guimeira/fpg8/docs/presentation.pdf

Worcester Polytechnic Institute

Department of Electrical and Computer Engineering

# FPG-8: A Chip-8/S-Chip implementation in Verilog

Guilherme Tebaldi Meira

### Chip-8

- Simple interpreted language
- Created in the mid-1970’s for the COSMAC VIP and Telmac 1800
- Focused on the creation of simple games
- “Hello world” of emulators

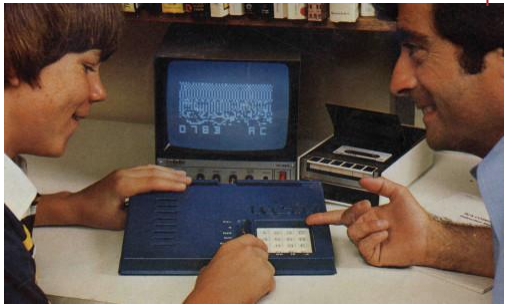
[picture p1: figure]

### Chip-8 Specifications

- 4kB of RAM
- 16 general purpose registers (V0-VF)
- Stack for function calls
- 60Hz Timers
- Delay timer
- Sound timer
- Hexadecimal keyboard
- 64x32 monochromatic display
- Sprites
- 8 pixels wide
- 1 to 10 pixels tall
- 35 opcodes

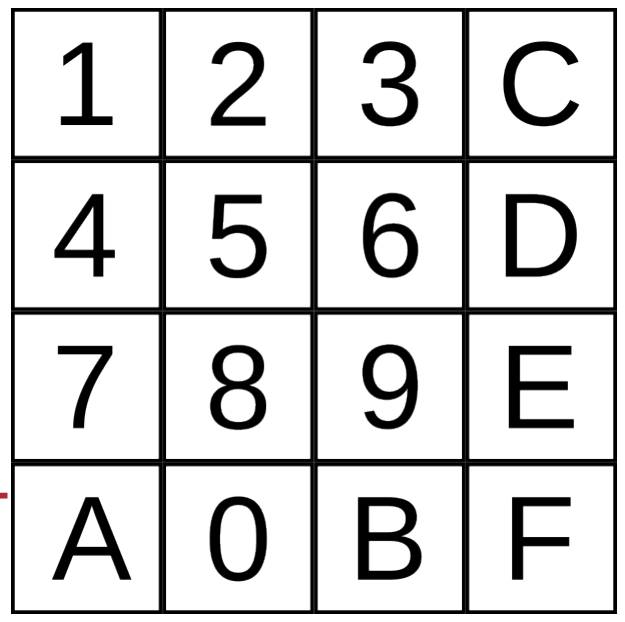
[picture p2: figure]

### S-Chip Extension

- 128x64 video mode
- 16x16 sprites
- 10 new opcodes
- Screen manipulation (scroll up, left and right)
- Switch between video modes
- Interaction with HP-48 (not implemented)
- Exit

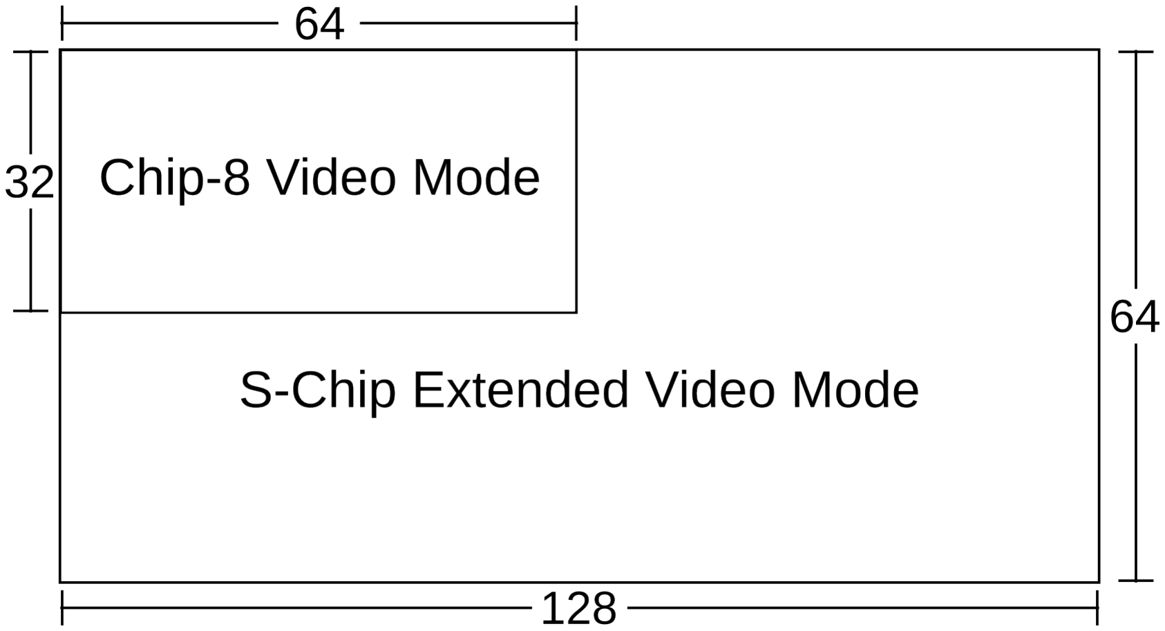
[picture p3: figure]
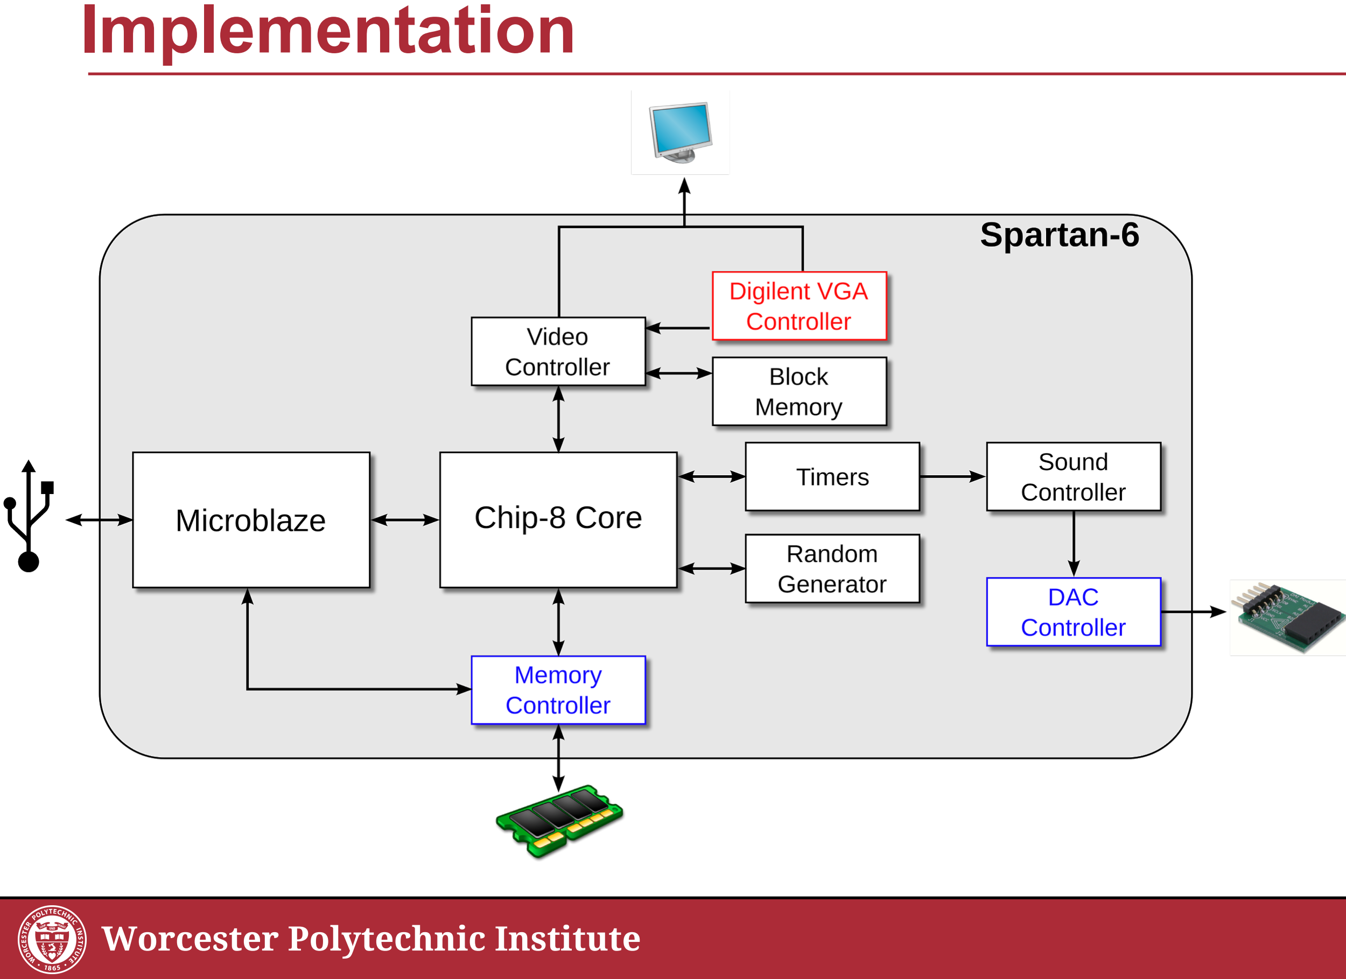
[picture p4: page 5]

### Implementation

### Serial Interface Protocol

- Load a game into the SRAM
- Start/stop the processor
- Debug mode
- Enable/disable debug mode
- Step to the next instruction
- Read registers
- Provide input
- Key pressed/key released commands
- Very inconvenient

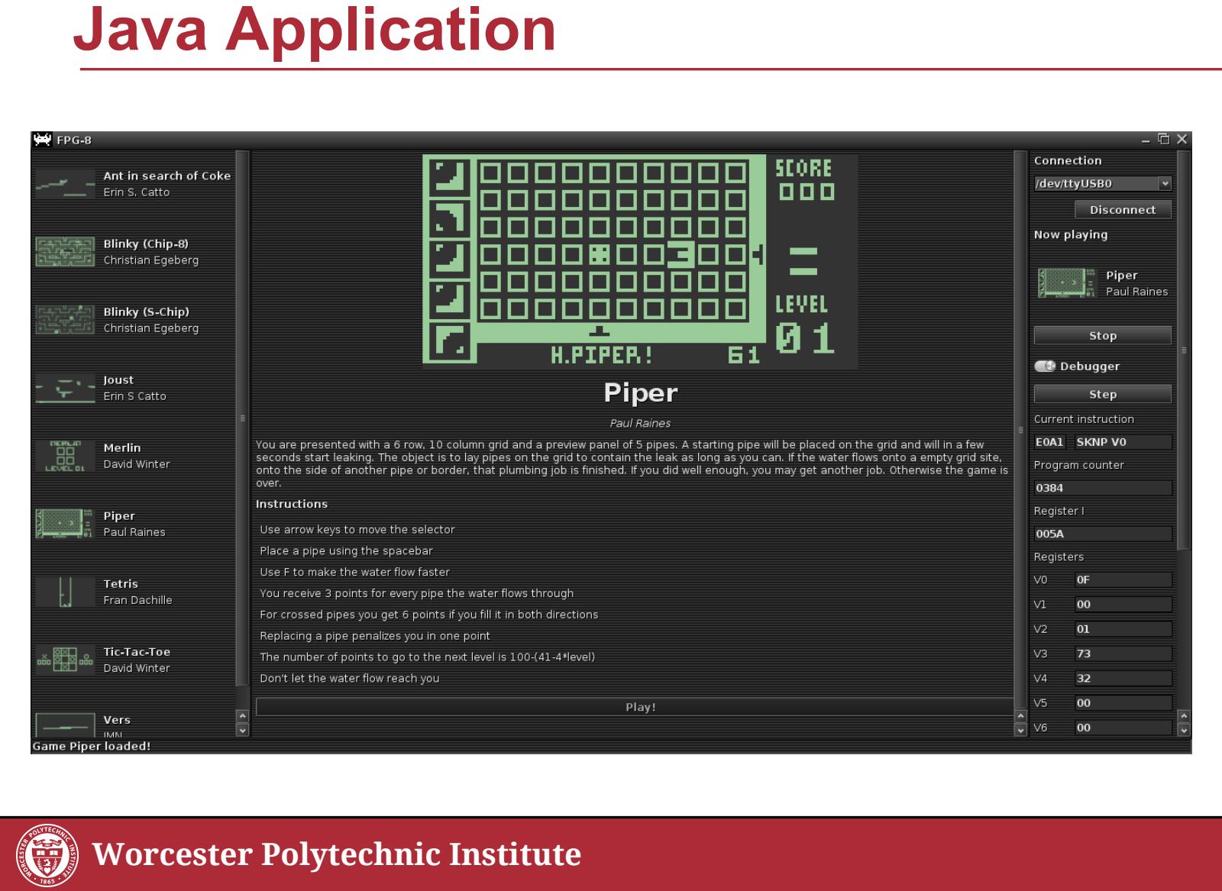
[picture p5: page 7]

### Java Application

### Testing

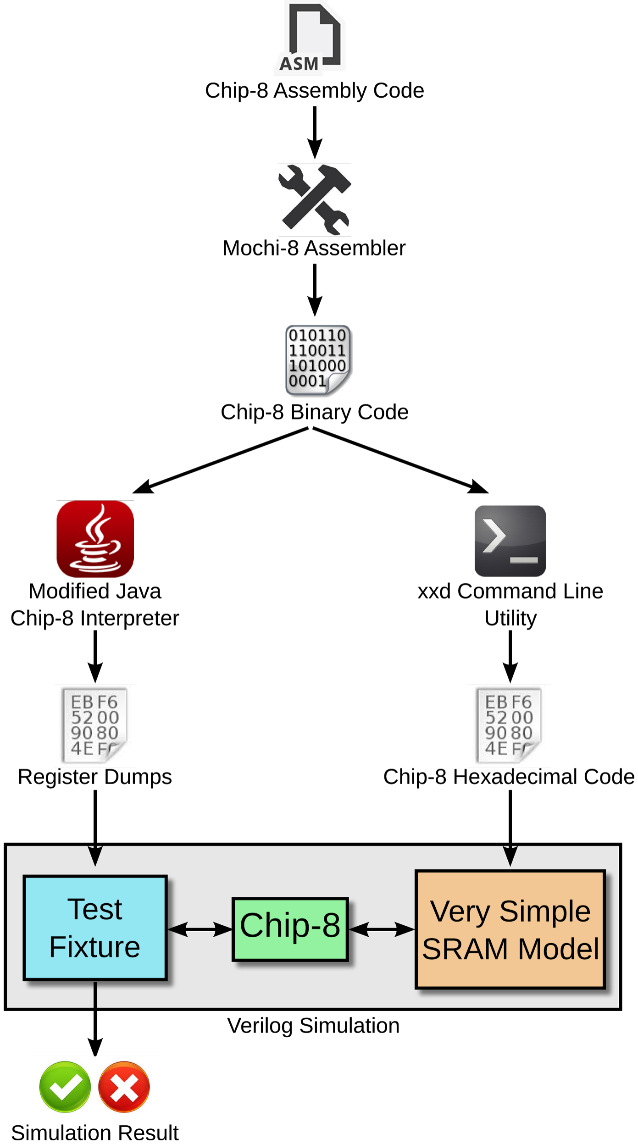
[picture p6: figure]

### Final Result

- H. Piper

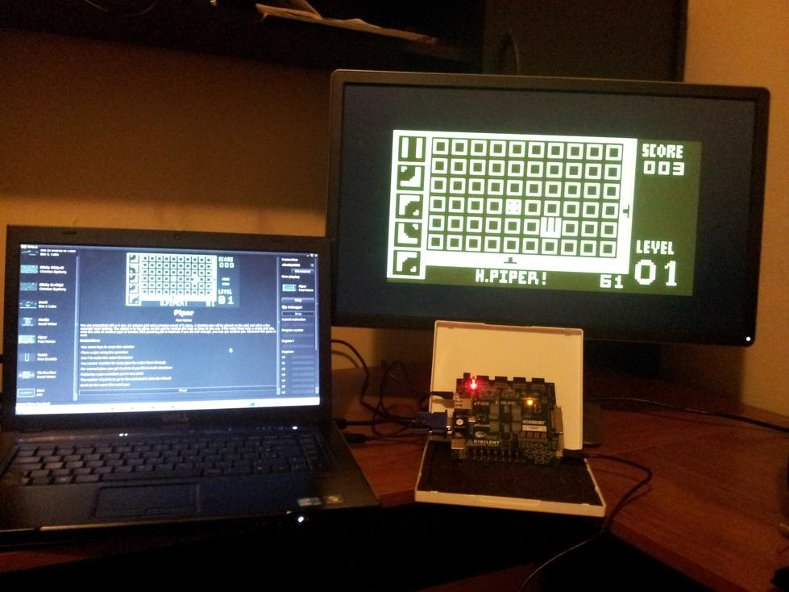
[picture p7: figure]

### Final Result

- Merlin

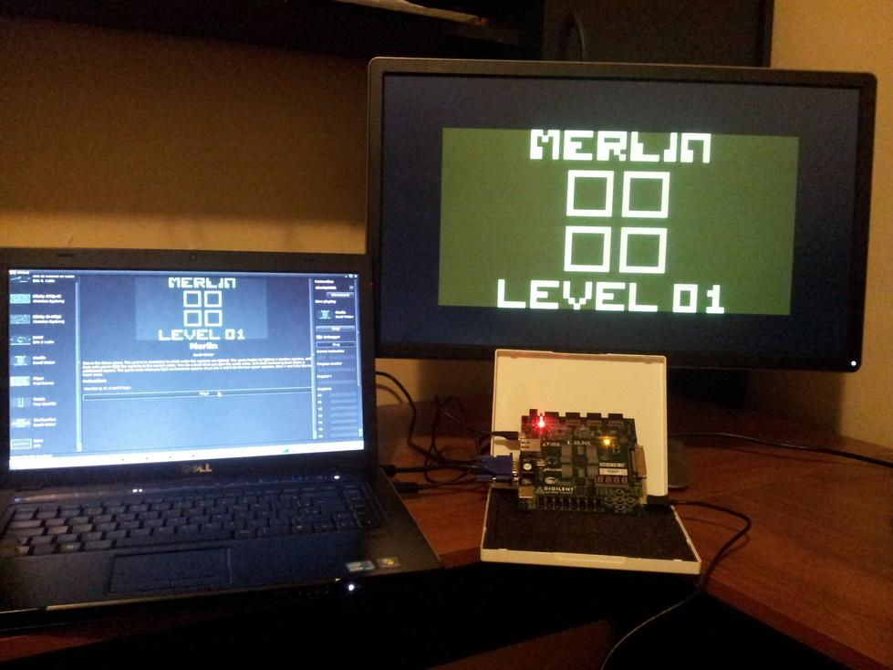
[picture p8: figure]

### Final Result

- Tic-Tac-Toe

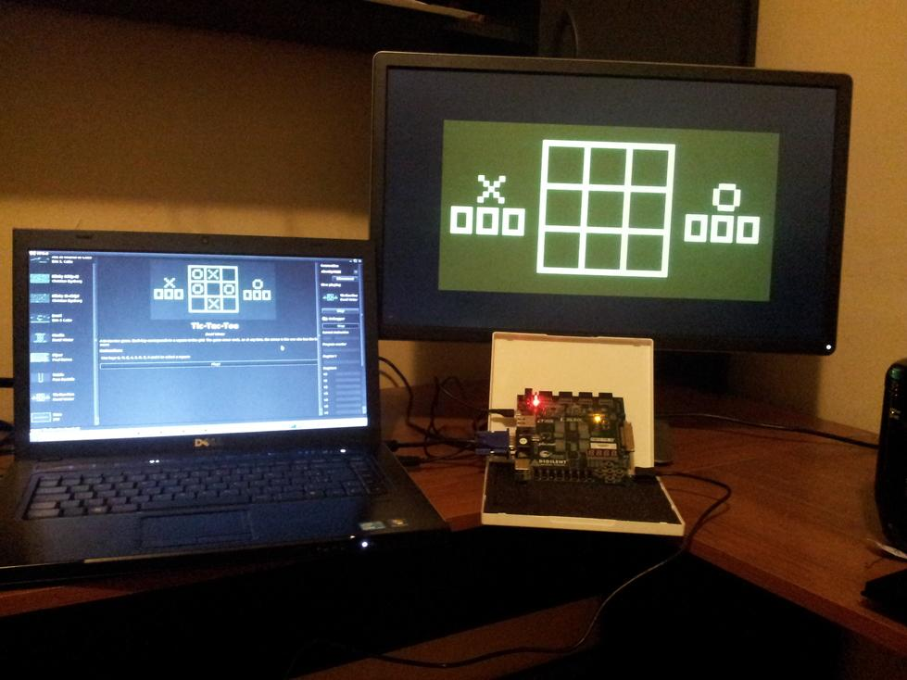
[picture p9: figure]

### Final Result

- Blinky (Chip-8)

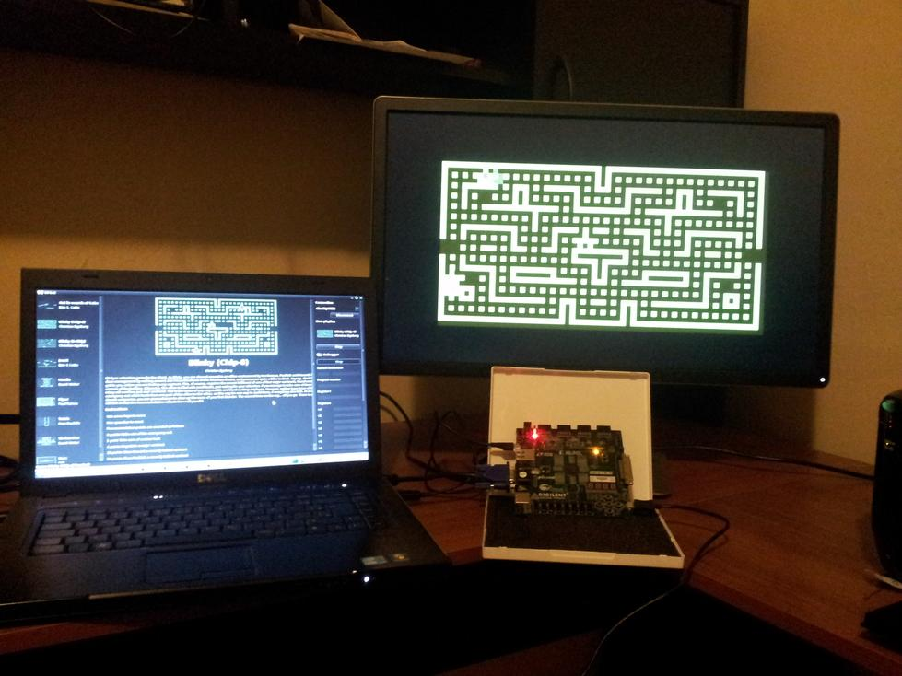
[picture p10: figure]

### Final Result

- Blinky (S-Chip)

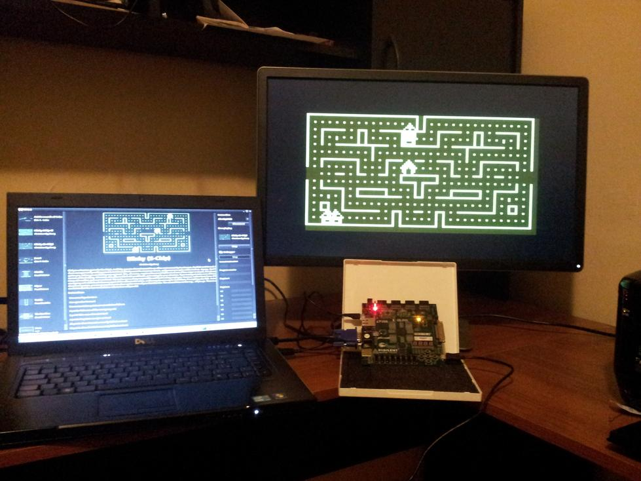
[picture p11: figure]

### Status

- Project is finished

### Fork me on GitHub! github.com/guimeira/fpg8

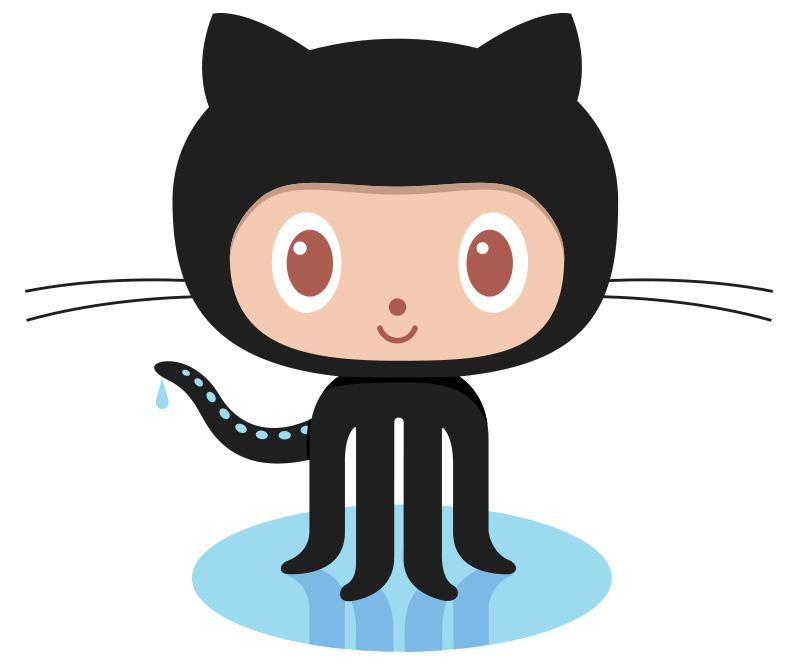
[picture p12: figure]

### Questions?

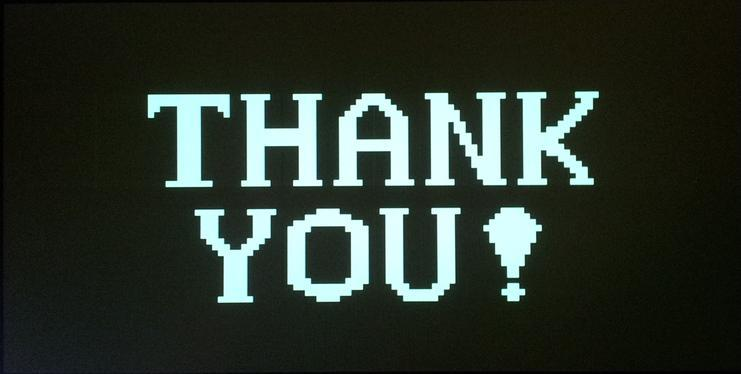
[picture p13: figure]
