guimeira/fpg8/(commit log)

2014-12-11 Added everything
    [fontmaker.ods]
2014-12-12 Added the hex data used in testing
    [dump.txt]
